Ho-Ro/Z80_dongle/Z80_dongle/TinyBasic2.h

#ifndef ROM_TB2_H
#define ROM_TB2_H

const unsigned char rom_tb2[] PROGMEM = {
    /* 0000 */ 0x31, 0x00, 0x09, 0x3e, 0xc9, 0xc3, 0x15, 0x01, 0xe3, 0xef, 0xbe, 0x23, 0x18, 0x61, 0x3e, 0x0d,
    /* 0010 */ 0xd3, 0x01, 0xfe, 0x0d, 0xc0, 0xc3, 0x01, 0x01, 0xcd, 0xda, 0x03, 0xe5, 0xc3, 0x96, 0x03, 0x57,
    /* 0020 */ 0x7c, 0xba, 0xc0, 0x7d, 0xbb, 0xc9, 0x00, 0x41, 0x1a, 0xfe, 0x20, 0xc0, 0x13, 0x18, 0xf9, 0x4e,
    /* 0030 */ 0xf1, 0xcd, 0x5e, 0x05, 0xc3, 0x71, 0x05, 0x47, 0xef, 0xd6, 0x40, 0xd8, 0x20, 0x1b, 0x13, 0xcd,
    /* 0040 */ 0x9e, 0x04, 0x29, 0xda, 0xdb, 0x00, 0x23, 0x23, 0xd5, 0xeb, 0xcd, 0xe0, 0x04, 0xe7, 0xda, 0x9f,
    /* 0050 */ 0x05, 0x21, 0x00, 0x21, 0xcd, 0x2b, 0x05, 0xd1, 0xc9, 0xfe, 0x21, 0x38, 0x02, 0xd6, 0x20, 0xfe,
    /* 0060 */ 0x1b, 0x3f, 0xd8, 0x13, 0x21, 0xfe, 0x07, 0x07, 0x85, 0x6f, 0x3e, 0x00, 0x8c, 0x67, 0xc9, 0x28,
    /* 0070 */ 0x07, 0xc5, 0x4e, 0x06, 0x00, 0x09, 0xc1, 0x1b, 0x13, 0x23, 0xe3, 0xc9, 0x21, 0x00, 0x00, 0x44,
    /* 0080 */ 0xcf, 0x27, 0x0b, 0x1a, 0x6f, 0x13, 0x1a, 0xfe, 0x27, 0x20, 0x6a, 0x13, 0x04, 0xc9, 0xfe, 0x24,
    /* 0090 */ 0x28, 0x22, 0xfe, 0x30, 0xd8, 0xfe, 0x3a, 0xd0, 0x3e, 0xf0, 0xa4, 0x20, 0x3e, 0x04, 0xc5, 0x44,
    /* 00a0 */ 0x4d, 0x29, 0x29, 0x09, 0x29, 0x1a, 0x13, 0xe6, 0x0f, 0x85, 0x6f, 0x3e, 0x00, 0x8c, 0x67, 0xc1,
    /* 00b0 */ 0x1a, 0xf2, 0x92, 0x00, 0x13, 0x1a, 0xfe, 0x30, 0xd8, 0xfe, 0x3a, 0x38, 0x0a, 0xfe, 0x41, 0xd8,
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
    /* 0260 */ 0x3a, 0x08, 0x7c, 0xb5, 0xca, 0x71, 0x05, 0xf9, 0xe1, 0x22, 0x3a, 0x08, 0xe1, 0x22, 0x38, 0x08,
    /* 0270 */ 0xd1, 0xcd, 0xd3, 0x06, 0xf7, 0xcd, 0xee, 0x06, 0xcd, 0x4f, 0x05, 0x2b, 0x22, 0x40, 0x08, 0x21,
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
};

#endif
