Ho-Ro/Z80_dongle/Z80_dongle/NascomBasic_GS.h

#ifndef ROM_GS_H
#define ROM_GS_H

// Credits
//
// * Original BASIC code was written by Microsoft.
// * Updates were made by Grant Searle.
// * Further updates from 8bitforce.

const uint8_t rom_gs[] PROGMEM = {
    /* 0000 */ 0xf3, 0xc3, 0x28, 0x00, 0x00, 0x00, 0x00, 0x00, 0xd3, 0x01, 0xc9, 0x00, 0x00, 0x00, 0x00, 0x00,
    /* 0010 */ 0xdf, 0x28, 0xfd, 0xdb, 0x01, 0xc9, 0x00, 0x00, 0xdb, 0x02, 0xe6, 0x01, 0xc9, 0x00, 0x00, 0x00,
    /* 0020 */ 0x7e, 0xb7, 0xc8, 0xcf, 0x23, 0x18, 0xf9, 0xc9, 0x21, 0x00, 0x3a, 0xf9, 0x3a, 0x00, 0x20, 0xfe,
    /* 0030 */ 0xc3, 0x20, 0x14, 0x21, 0x5d, 0x00, 0xcd, 0x20, 0x00, 0xd7, 0xe6, 0xdf, 0xfe, 0x43, 0x20, 0x0f,
    /* 0040 */ 0xcf, 0x3e, 0x0d, 0xcf, 0x3e, 0x0a, 0xcf, 0x3e, 0xc3, 0x32, 0x00, 0x20, 0xc3, 0x00, 0x01, 0xfe,
    /* 0050 */ 0x57, 0x20, 0xe6, 0xcf, 0x3e, 0x0d, 0xcf, 0x3e, 0x0a, 0xcf, 0xc3, 0x03, 0x01, 0x0d, 0x0a, 0x28,
    /* 0060 */ 0x43, 0x29, 0x6f, 0x6c, 0x64, 0x20, 0x6f, 0x72, 0x20, 0x28, 0x57, 0x29, 0x61, 0x72, 0x6d, 0x20,
    /* 0070 */ 0x73, 0x74, 0x61, 0x72, 0x74, 0x3f, 0x20, 0x00, 0x00, 0x00, 0x00, 0x00, 0x00, 0x00, 0x00, 0x00,
    /* 0080 */ 0x00, 0x00, 0x00, 0x00, 0x00, 0x00, 0x00, 0x00, 0x00, 0x00, 0x00, 0x00, 0x00, 0x00, 0x00, 0x00,
    /* 0090 */ 0x00, 0x00, 0x00, 0x00, 0x00, 0x00, 0x00, 0x00, 0x00, 0x00, 0x00, 0x00, 0x00, 0x00, 0x00, 0x00,
    /* 00a0 */ 0x00, 0x00, 0x00, 0x00, 0x00, 0x00, 0x00, 0x00, 0x00, 0x00, 0x00, 0x00, 0x00, 0x00, 0x00, 0x00,
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
    /* 1fe0 */ 0x00, 0x00, 0x00, 0x00, 0x00, 0x00, 0x00, 0x00, 0x00, 0x00, 0x00, 0x00, 0x00, 0x00, 0x00, 0x00,
    /* 1ff0 */ 0x00, 0x00, 0x00, 0x00, 0x00, 0x00, 0x00, 0x00, 0x00, 0x00, 0x00, 0x00, 0x00, 0x00, 0x00, 0x00
};

#endif
