Ho-Ro/Z80_dongle/Z80_dongle/NascomBasic_HP.h

#ifndef ROM_HP_H
#define ROM_HP_H

// Hein Pragt's modified version of Z80 Basic interpreter from Grant's site
// RAM top address is hardcoded at the command at $0185: 21 00 38 ; LD HL,$3800
// changed for my dongle: read RAM top from RAM (must be set before start of simulation
// $0185: 21 00 38 LD HL,$3800 -> 2A 00 20 LD HL, ($2000) (marked below)
// Check 6850 RDRF (receive data register full) bit only
// $0029: B7 C9 7E (OR A; RET; LD A,(HL)) -> E6 01 C9 (AND 1; RET)

const uint8_t rom_hp[] PROGMEM = {
    0xF3, 0xC3, 0x68, 0x01, 0x00, 0x00, 0x00, 0x00, 0xC3, 0x24, 0x00, 0x00, 0x00, 0x00, 0x00, 0x00, 0xC3, 0x1B, 0x00, 0x00, 0x00,
    0x00, 0x00, 0x00, 0xC3, 0x27, 0x00, 0xDB, 0x02, 0xFE, 0x00, 0x28, 0xFA, 0xDB, 0x01, 0xC9, 0xD3, 0x01, 0xC9, 0xDB, 0x01,
    // 0xB7, 0xC9, 0x7E, // OR A; RET; LD A; (HL)
    0xE6, 0x01, 0xC9, //    AND 1; RET
    0xB7, 0xC8, 0xCF, 0x23, 0x18, 0x39, 0xC9, 0x21, 0xED, 0x20, 0xF9, 0xFB, 0x21, 0x71, 0x00, 0xCD, 0x6B, 0x0B, 0x3A,
    0x00, 0x00, 0xFE, 0x59, 0x20, 0x16, 0x21, 0x8C, 0x00, 0xCD, 0x6B, 0x0B, 0xCD, 0x1B, 0x00, 0xE6, 0xDF, 0xFE, 0x43, 0x20, 0x0F,
    0xCF, 0x3E, 0x0D, 0xCF, 0x3E, 0x0A, 0xCF, 0x3E, 0x59, 0x32, 0x00, 0x00, 0xC3, 0x50, 0x01, 0xFE, 0x57, 0x20, 0xE4, 0xCF, 0x3E,
    0x0D, 0xCF, 0x3E, 0x0A, 0xCF, 0xC3, 0x53, 0x01, 0x0C, 0x5A, 0x38, 0x30, 0x20, 0x53, 0x42, 0x43, 0x20, 0x42, 0x79, 0x20, 0x47,
    0x72, 0x61, 0x6E, 0x74, 0x20, 0x53, 0x65, 0x61, 0x72, 0x6C, 0x65, 0x0D, 0x0A, 0x00, 0x0D, 0x0A, 0x43, 0x6F, 0x6C, 0x64, 0x20,
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
    0x00, 0x00, 0x00, 0x00, 0x00, 0x00, 0x00, 0x00, 0x00, 0x00, 0x00, 0x00, 0x00, 0x00, 0x00, 0x00, 0x00, 0x00, 0x00, 0x00, 0x00,
    0x00, 0x00, 0x00, 0x00, 0x00, 0x00, 0x00, 0x00, 0x00, 0x00, 0x00, 0x00, 0x00, 0x00, 0x00, 0x00, 0x00, 0x00, 0x00, 0x00, 0x00,
    0x00, 0x00,

};


#endif
