Ho-Ro/Z80_dongle/Z80_dongle/opcodes.h

PROGMEM const char opcode[][14] = {
    /*00*/ "NOP          ",
    /*01*/ "LD BC,NNNN   ",
    /*02*/ "LD (BC),A    ",
    /*03*/ "INC BC       ",
    /*04*/ "INC B        ",
    /*05*/ "DEC B        ",
    /*06*/ "LD B,NN      ",
    /*07*/ "RLCA         ",
    /*08*/ "EX AF,AF'    ",
    /*09*/ "ADD HL,BC    ",
    /*0A*/ "LD A,(BC)    ",
    /*0B*/ "DEC BC       ",
    /*0C*/ "INC C        ",
    /*0D*/ "DEC C        ",
    /*0E*/ "LD C,NN      ",
    /*0F*/ "RRCA         ",
    /*10*/ "DJNZ NN      ",
    /*11*/ "LD DE,NNNN   ",
    /*12*/ "LD (DE),A    ",
    /*13*/ "INC DE       ",
    /*14*/ "INC D        ",
    /*15*/ "DEC D        ",
    /*16*/ "LD D,NN      ",
    /*17*/ "RLA          ",
    /*18*/ "JR NN        ",
    /*19*/ "ADD HL,DE    ",
    /*1A*/ "LD A,(DE)    ",
    /*1B*/ "DEC DE       ",
    /*1C*/ "INC E        ",
    /*1D*/ "DEC E        ",
    /*1E*/ "LD E,NN      ",
    /*1F*/ "RRA          ",
    /*20*/ "JR NZ,NN     ",
    /*21*/ "LD HL,NNNN   ",
    /*22*/ "LD (NNNN),HL ",
    /*23*/ "INC HL       ",
    /*24*/ "INC H        ",
    /*25*/ "DEC H        ",
    /*26*/ "LD H,NN      ",
    /*27*/ "DAA          ",
    /*28*/ "JR Z,NN      ",
    /*29*/ "ADD HL,HL    ",
    /*2A*/ "LD HL,(NNNN) ",
    /*2B*/ "DEC HL       ",
    /*2C*/ "INC L        ",
    /*2D*/ "DEC L        ",
    /*2E*/ "LD L,NN      ",
    /*2F*/ "CPL          ",
    /*30*/ "JR NC,NN     ",
    /*31*/ "LD SP,NNNN   ",
    /*32*/ "LD (NNNN),A  ",
    /*33*/ "INC SP       ",
    /*34*/ "INC (HL)     ",
    /*35*/ "DEC (HL)     ",
    /*36*/ "LD (HL),NN   ",
    /*37*/ "SCF          ",
    /*38*/ "JR C,NN      ",
    /*39*/ "ADD HL,SP    ",
    /*3A*/ "LD A,(NNNN)  ",
    /*3B*/ "DEC SP       ",
    /*3C*/ "INC A        ",
    /*3D*/ "DEC A        ",
    /*3E*/ "LD A,NN      ",
    /*3F*/ "CCF          ",
    /*40*/ "LD B,B       ",
    /*41*/ "LD B,C       ",
    /*42*/ "LD B,D       ",
    /*43*/ "LD B,E       ",
    /*44*/ "LD B,H       ",
    /*45*/ "LD B,L       ",
    /*46*/ "LD B,(HL)    ",
    /*47*/ "LD B,A       ",
    /*48*/ "LD C,B       ",
    /*49*/ "LD C,C       ",
    /*4A*/ "LD C,D       ",
    /*4B*/ "LD C,E       ",
    /*4C*/ "LD C,H       ",
    /*4D*/ "LD C,L       ",
    /*4E*/ "LD C,(HL)    ",
    /*4F*/ "LD C,A       ",
    /*50*/ "LD D,B       ",
    /*51*/ "LD D,C       ",
    /*52*/ "LD D,D       ",
    /*53*/ "LD D,E       ",
    /*54*/ "LD D,H       ",
    /*55*/ "LD D,L       ",
    /*56*/ "LD D,(HL)    ",
    /*57*/ "LD D,A       ",
    /*58*/ "LD E,B       ",
    /*59*/ "LD E,C       ",
    /*5A*/ "LD E,D       ",
    /*5B*/ "LD E,E       ",
    /*5C*/ "LD E,H       ",
    /*5D*/ "LD E,L       ",
    /*5E*/ "LD E,(HL)    ",
    /*5F*/ "LD E,A       ",
    /*60*/ "LD H,B       ",
    /*61*/ "LD H,C       ",
    /*62*/ "LD H,D       ",
    /*63*/ "LD H,E       ",
    /*64*/ "LD H,H       ",
    /*65*/ "LD H,L       ",
    /*66*/ "LD H,(HL)    ",
    /*67*/ "LD H,A       ",
    /*68*/ "LD L,B       ",
    /*69*/ "LD L,C       ",
    /*6A*/ "LD L,D       ",
    /*6B*/ "LD L,E       ",
    /*6C*/ "LD L,H       ",
    /*6D*/ "LD L,L       ",
    /*6E*/ "LD L,(HL)    ",
    /*6F*/ "LD L,A       ",
    /*70*/ "LD (HL),B    ",
    /*71*/ "LD (HL),C    ",
    /*72*/ "LD (HL),D    ",
    /*73*/ "LD (HL),E    ",
    /*74*/ "LD (HL),H    ",
    /*75*/ "LD (HL),L    ",
    /*76*/ "HALT         ",
    /*77*/ "LD (HL),A    ",
    /*78*/ "LD A,B       ",
    /*79*/ "LD A,C       ",
    /*7A*/ "LD A,D       ",
    /*7B*/ "LD A,E       ",
    /*7C*/ "LD A,H       ",
    /*7D*/ "LD A,L       ",
    /*7E*/ "LD A,(HL)    ",
    /*7F*/ "LD A,A       ",
    /*80*/ "ADD A,B      ",
    /*81*/ "ADD A,C      ",
    /*82*/ "ADD A,D      ",
    /*83*/ "ADD A,E      ",
    /*84*/ "ADD A,H      ",
    /*85*/ "ADD A,L      ",
    /*86*/ "ADD A,(HL)   ",
    /*87*/ "ADD A,A      ",
    /*88*/ "ADC A,B      ",
    /*89*/ "ADC A,C      ",
    /*8A*/ "ADC A,D      ",
    /*8B*/ "ADC A,E      ",
    /*8C*/ "ADC A,H      ",
    /*8D*/ "ADC A,L      ",
    /*8E*/ "ADC A,(HL)   ",
    /*8F*/ "ADC A,A      ",
    /*90*/ "SUB B        ",
    /*91*/ "SUB C        ",
    /*92*/ "SUB D        ",
    /*93*/ "SUB E        ",
    /*94*/ "SUB H        ",
    /*95*/ "SUB L        ",
    /*96*/ "SUB (HL)     ",
    /*97*/ "SUB A        ",
    /*98*/ "SBC B        ",
    /*99*/ "SBC C        ",
    /*9A*/ "SBC D        ",
    /*9B*/ "SBC E        ",
    /*9C*/ "SBC H        ",
    /*9D*/ "SBC L        ",
    /*9E*/ "SBC (HL)     ",
    /*9F*/ "SBC A        ",
    /*A0*/ "AND B        ",
    /*A1*/ "AND C        ",
    /*A2*/ "AND D        ",
    /*A3*/ "AND E        ",
    /*A4*/ "AND H        ",
    /*A5*/ "AND L        ",
    /*A6*/ "AND (HL)     ",
    /*A7*/ "AND A        ",
    /*A8*/ "XOR B        ",
    /*A9*/ "XOR C        ",
    /*AA*/ "XOR D        ",
    /*AB*/ "XOR E        ",
    /*AC*/ "XOR H        ",
    /*AD*/ "XOR L        ",
    /*AE*/ "XOR (HL)     ",
    /*AF*/ "XOR A        ",
    /*B0*/ "OR B         ",
    /*B1*/ "OR C         ",
    /*B2*/ "OR D         ",
    /*B3*/ "OR E         ",
    /*B4*/ "OR H         ",
    /*B5*/ "OR L         ",
    /*B6*/ "OR (HL)      ",
    /*B7*/ "OR A         ",
    /*B8*/ "CP B         ",
    /*B9*/ "CP C         ",
    /*BA*/ "CP D         ",
    /*BB*/ "CP E         ",
    /*BC*/ "CP H         ",
    /*BD*/ "CP L         ",
    /*BE*/ "CP (HL)      ",
    /*BF*/ "CP A         ",
    /*C0*/ "RET NZ       ",
    /*C1*/ "POP BC       ",
    /*C2*/ "JP NZ,NNNN   ",
    /*C3*/ "JP NNNN      ",
    /*C4*/ "CALL NZ,NNNN ",
    /*C5*/ "PUSH BC      ",
    /*C6*/ "ADD A,NN     ",
    /*C7*/ "RST 0        ",
    /*C8*/ "RET Z        ",
    /*C9*/ "RET          ",
    /*CA*/ "JP Z,NNNN    ",
    /*CB*/ "PREFIX CB    ",
    /*CC*/ "CALL Z,NNNN  ",
    /*CD*/ "CALL NNNN    ",
    /*CE*/ "ADC A,NN     ",
    /*CF*/ "RST 8H       ",
    /*D0*/ "RET NC       ",
    /*D1*/ "POP DE       ",
    /*D2*/ "JP NC,NNNN   ",
    /*D3*/ "OUT (NN),A   ",
    /*D4*/ "CALL NC,NNNN ",
    /*D5*/ "PUSH DE      ",
    /*D6*/ "SUB NN       ",
    /*D7*/ "RST 10H      ",
    /*D8*/ "RET C        ",
    /*D9*/ "EXX          ",
    /*DA*/ "JP C,NNNN    ",
    /*DB*/ "IN A,(NN)    ",
    /*DC*/ "CALL C,NNNN  ",
    /*DD*/ "PREFIX DD    ",
    /*DE*/ "SBC A,NN     ",
    /*DF*/ "RST 18H      ",
    /*E0*/ "RET PO       ",
    /*E1*/ "POP HL       ",
    /*E2*/ "JP PO,NNNN   ",
    /*E3*/ "EX (SP),HL   ",
    /*E4*/ "CALL PO,NNNN ",
    /*E5*/ "PUSH HL      ",
    /*E6*/ "AND NN       ",
    /*E7*/ "RST 20H      ",
    /*E8*/ "RET PE       ",
    /*E9*/ "JP (HL)      ",
    /*EA*/ "JP PE,NNNN   ",
    /*EB*/ "EX DE,HL     ",
    /*EC*/ "CALL PE,NNNN ",
    /*ED*/ "PREFIX ED    ",
    /*EE*/ "XOR NN       ",
    /*EF*/ "RST 28H      ",
    /*F0*/ "RET P        ",
    /*F1*/ "POP AF       ",
    /*F2*/ "JP P,NNNN    ",
    /*F3*/ "DI           ",
    /*F4*/ "CALL P,NNNN  ",
    /*F5*/ "PUSH AF      ",
    /*F6*/ "OR NN        ",
    /*F7*/ "RST 30H      ",
    /*F8*/ "RET M        ",
    /*F9*/ "LD SP,HL     ",
    /*FA*/ "JP M,NNNN    ",
    /*FB*/ "EI           ",
    /*FC*/ "CALL M,NNNN  ",
    /*FD*/ "PREFIX FD    ",
    /*FE*/ "CP NN        ",
    /*FF*/ "RST 38H      "
};

PROGMEM const char opcodeCB[][14] = {
    /*00*/ "RLC B        ",
    /*01*/ "RLC C        ",
    /*02*/ "RLC D        ",
    /*03*/ "RLC E        ",
    /*04*/ "RLC H        ",
    /*05*/ "RLC L        ",
    /*06*/ "RLC (HL)     ",
    /*07*/ "RLC A        ",
    /*08*/ "RRC B        ",
    /*09*/ "RRC C        ",
    /*0A*/ "RRC D        ",
    /*0B*/ "RRC E        ",
    /*0C*/ "RRC H        ",
    /*0D*/ "RRC L        ",
    /*0E*/ "RRC (HL)     ",
    /*0F*/ "RRC A        ",
    /*10*/ "RL  B        ",
    /*11*/ "RL  C        ",
    /*12*/ "RL  D        ",
    /*13*/ "RL  E        ",
    /*14*/ "RL  H        ",
    /*15*/ "RL  L        ",
    /*16*/ "RL  (HL)     ",
    /*17*/ "RL  A        ",
    /*18*/ "RR  B        ",
    /*19*/ "RR  C        ",
    /*1A*/ "RR  D        ",
    /*1B*/ "RR  E        ",
    /*1C*/ "RR  H        ",
    /*1D*/ "RR  L        ",
    /*1E*/ "RR  (HL)     ",
    /*1F*/ "RR  A        ",
    /*20*/ "SLA B        ",
    /*21*/ "SLA C        ",
    /*22*/ "SLA D        ",
    /*23*/ "SLA E        ",
    /*24*/ "SLA H        ",
    /*25*/ "SLA L        ",
    /*26*/ "SLA (HL)     ",
    /*27*/ "SLA A        ",
    /*28*/ "SRA B        ",
    /*29*/ "SRA C        ",
    /*2A*/ "SRA D        ",
    /*2B*/ "SRA E        ",
    /*2C*/ "SRA H        ",
    /*2D*/ "SRA L        ",
    /*2E*/ "SRA (HL)     ",
    /*2F*/ "SRA A        ",
    /*30*/ "",
    /*31*/ "",
    /*32*/ "",
    /*33*/ "",
    /*34*/ "",
    /*35*/ "",
    /*36*/ "",
    /*37*/ "",
    /*38*/ "SRL B        ",
    /*39*/ "SRL C        ",
    /*3A*/ "SRL D        ",
    /*3B*/ "SRL E        ",
    /*3C*/ "SRL H        ",
    /*3D*/ "SRL L        ",
    /*3E*/ "SRL (HL)     ",
    /*3F*/ "SRL A        ",
    /*40*/ "BIT 0,B      ",
    /*41*/ "BIT 0,C      ",
    /*42*/ "BIT 0,D      ",
    /*43*/ "BIT 0,E      ",
    /*44*/ "BIT 0,H      ",
    /*45*/ "BIT 0,L      ",
    /*46*/ "BIT 0,(HL)   ",
    /*47*/ "BIT 0,A      ",
    /*48*/ "BIT 1,B      ",
    /*49*/ "BIT 1,C      ",
    /*4A*/ "BIT 1,D      ",
    /*4B*/ "BIT 1,E      ",
    /*4C*/ "BIT 1,H      ",
    /*4D*/ "BIT 1,L      ",
    /*4E*/ "BIT 1,(HL)   ",
    /*4F*/ "BIT 1,A      ",
    /*50*/ "BIT 2,B      ",
    /*51*/ "BIT 2,C      ",
    /*52*/ "BIT 2,D      ",
    /*53*/ "BIT 2,E      ",
    /*54*/ "BIT 2,H      ",
    /*55*/ "BIT 2,L      ",
    /*56*/ "BIT 2,(HL)   ",
    /*57*/ "BIT 2,A      ",
    /*58*/ "BIT 3,B      ",
    /*59*/ "BIT 3,C      ",
    /*5A*/ "BIT 3,D      ",
    /*5B*/ "BIT 3,E      ",
    /*5C*/ "BIT 3,H      ",
    /*5D*/ "BIT 3,L      ",
    /*5E*/ "BIT 3,(HL)   ",
    /*5F*/ "BIT 3,A      ",
    /*60*/ "BIT 4,B      ",
    /*61*/ "BIT 4,C      ",
    /*62*/ "BIT 4,D      ",
    /*63*/ "BIT 4,E      ",
    /*64*/ "BIT 4,H      ",
    /*65*/ "BIT 4,L      ",
    /*66*/ "BIT 4,(HL)   ",
    /*67*/ "BIT 4,A      ",
    /*68*/ "BIT 5,B      ",
    /*69*/ "BIT 5,C      ",
    /*6A*/ "BIT 5,D      ",
    /*6B*/ "BIT 5,E      ",
    /*6C*/ "BIT 5,H      ",
    /*6D*/ "BIT 5,L      ",
    /*6E*/ "BIT 5,(HL)   ",
    /*6F*/ "BIT 5,A      ",
    /*70*/ "BIT 6,B      ",
    /*71*/ "BIT 6,C      ",
    /*72*/ "BIT 6,D      ",
    /*73*/ "BIT 6,E      ",
    /*74*/ "BIT 6,H      ",
    /*75*/ "BIT 6,L      ",
    /*76*/ "BIT 6,(HL)   ",
    /*77*/ "BIT 6,A      ",
    /*78*/ "BIT 7,B      ",
    /*79*/ "BIT 7,C      ",
    /*7A*/ "BIT 7,D      ",
    /*7B*/ "BIT 7,E      ",
    /*7C*/ "BIT 7,H      ",
    /*7D*/ "BIT 7,L      ",
    /*7E*/ "BIT 7,(HL)   ",
    /*7F*/ "BIT 7,A      ",
    /*80*/ "RES 0,B      ",
    /*81*/ "RES 0,C      ",
    /*82*/ "RES 0,D      ",
    /*83*/ "RES 0,E      ",
    /*84*/ "RES 0,H      ",
    /*85*/ "RES 0,L      ",
    /*86*/ "RES 0,(HL)   ",
    /*87*/ "RES 0,A      ",
    /*88*/ "RES 1,B      ",
    /*89*/ "RES 1,C      ",
    /*8A*/ "RES 1,D      ",
    /*8B*/ "RES 1,E      ",
    /*8C*/ "RES 1,H      ",
    /*8D*/ "RES 1,L      ",
    /*8E*/ "RES 1,(HL)   ",
    /*8F*/ "RES 1,A      ",
    /*90*/ "RES 2,B      ",
    /*91*/ "RES 2,C      ",
    /*92*/ "RES 2,D      ",
    /*93*/ "RES 2,E      ",
    /*94*/ "RES 2,H      ",
    /*95*/ "RES 2,L      ",
    /*96*/ "RES 2,(HL)   ",
    /*97*/ "RES 2,A      ",
    /*98*/ "RES 3,B      ",
    /*99*/ "RES 3,C      ",
    /*9A*/ "RES 3,D      ",
    /*9B*/ "RES 3,E      ",
    /*9C*/ "RES 3,H      ",
    /*9D*/ "RES 3,L      ",
    /*9E*/ "RES 3,(HL)   ",
    /*9F*/ "RES 3,A      ",
    /*A0*/ "RES 4,B      ",
    /*A1*/ "RES 4,C      ",
    /*A2*/ "RES 4,D      ",
    /*A3*/ "RES 4,E      ",
    /*A4*/ "RES 4,H      ",
    /*A5*/ "RES 4,L      ",
    /*A6*/ "RES 4,(HL)   ",
    /*A7*/ "RES 4,A      ",
    /*A8*/ "RES 5,B      ",
    /*A9*/ "RES 5,C      ",
    /*AA*/ "RES 5,D      ",
    /*AB*/ "RES 5,E      ",
    /*AC*/ "RES 5,H      ",
    /*AD*/ "RES 5,L      ",
    /*AE*/ "RES 5,(HL)   ",
    /*AF*/ "RES 5,A      ",
    /*B0*/ "RES 6,B      ",
    /*B1*/ "RES 6,C      ",
    /*B2*/ "RES 6,D      ",
    /*B3*/ "RES 6,E      ",
    /*B4*/ "RES 6,H      ",
    /*B5*/ "RES 6,L      ",
    /*B6*/ "RES 6,(HL)   ",
    /*B7*/ "RES 6,A      ",
    /*B8*/ "RES 7,B      ",
    /*B9*/ "RES 7,C      ",
    /*BA*/ "RES 7,D      ",
    /*BB*/ "RES 7,E      ",
    /*BC*/ "RES 7,H      ",
    /*BD*/ "RES 7,L      ",
    /*BE*/ "RES 7,(HL)   ",
    /*BF*/ "RES 7,A      ",
    /*C0*/ "SET 0,B      ",
    /*C1*/ "SET 0,C      ",
    /*C2*/ "SET 0,D      ",
    /*C3*/ "SET 0,E      ",
    /*C4*/ "SET 0,H      ",
    /*C5*/ "SET 0,L      ",
    /*C6*/ "SET 0,(HL)   ",
    /*C7*/ "SET 0,A      ",
    /*C8*/ "SET 1,B      ",
    /*C9*/ "SET 1,C      ",
    /*CA*/ "SET 1,D      ",
    /*CB*/ "SET 1,E      ",
    /*CC*/ "SET 1,H      ",
    /*CD*/ "SET 1,L      ",
    /*CE*/ "SET 1,(HL)   ",
    /*CF*/ "SET 1,A      ",
    /*D0*/ "SET 2,B      ",
    /*D1*/ "SET 2,C      ",
    /*D2*/ "SET 2,D      ",
    /*D3*/ "SET 2,E      ",
    /*D4*/ "SET 2,H      ",
    /*D5*/ "SET 2,L      ",
    /*D6*/ "SET 2,(HL)   ",
    /*D7*/ "SET 2,A      ",
    /*D8*/ "SET 3,B      ",
    /*D9*/ "SET 3,C      ",
    /*DA*/ "SET 3,D      ",
    /*DB*/ "SET 3,E      ",
    /*DC*/ "SET 3,H      ",
    /*DD*/ "SET 3,L      ",
    /*DE*/ "SET 3,(HL)   ",
    /*DF*/ "SET 3,A      ",
    /*E0*/ "SET 4,B      ",
    /*E1*/ "SET 4,C      ",
    /*E2*/ "SET 4,D      ",
    /*E3*/ "SET 4,E      ",
    /*E4*/ "SET 4,H      ",
    /*E5*/ "SET 4,L      ",
    /*E6*/ "SET 4,(HL)   ",
    /*E7*/ "SET 4,A      ",
    /*E8*/ "SET 5,B      ",
    /*E9*/ "SET 5,C      ",
    /*EA*/ "SET 5,D      ",
    /*EB*/ "SET 5,E      ",
    /*EC*/ "SET 5,H      ",
    /*ED*/ "SET 5,L      ",
    /*EE*/ "SET 5,(HL)   ",
    /*EF*/ "SET 5,A      ",
    /*F0*/ "SET 6,B      ",
    /*F1*/ "SET 6,C      ",
    /*F2*/ "SET 6,D      ",
    /*F3*/ "SET 6,E      ",
    /*F4*/ "SET 6,H      ",
    /*F5*/ "SET 6,L      ",
    /*F6*/ "SET 6,(HL)   ",
    /*F7*/ "SET 6,A      ",
    /*F8*/ "SET 7,B      ",
    /*F9*/ "SET 7,C      ",
    /*FA*/ "SET 7,D      ",
    /*FB*/ "SET 7,E      ",
    /*FC*/ "SET 7,H      ",
    /*FD*/ "SET 7,L      ",
    /*FE*/ "SET 7,(HL)   ",
    /*FF*/ "SET 7,A      "
};

PROGMEM const char opcodeDD[][14] = {
    /*00*/ "",
    /*01*/ "",
    /*02*/ "",
    /*03*/ "",
    /*04*/ "",
    /*05*/ "",
    /*06*/ "",
    /*07*/ "",
    /*08*/ "",
    /*09*/ "ADD IX,BC    ",
    /*0A*/ "",
    /*0B*/ "",
    /*0C*/ "",
    /*0D*/ "",
    /*0E*/ "",
    /*0F*/ "",
    /*10*/ "",
    /*11*/ "",
    /*12*/ "",
    /*13*/ "",
    /*14*/ "",
    /*15*/ "",
    /*16*/ "",
    /*17*/ "",
    /*18*/ "",
    /*19*/ "ADD IX,DE    ",
    /*1A*/ "",
    /*1B*/ "",
    /*1C*/ "",
    /*1D*/ "",
    /*1E*/ "",
    /*1F*/ "",
    /*20*/ "",
    /*21*/ "LD IX,NNNN   ",
    /*22*/ "LD (NNNN),IX ",
    /*23*/ "INC IX       ",
    /*24*/ "INC IXH      ",
    /*25*/ "DEC IXH      ",
    /*26*/ "LD  IXH,NN   ",
    /*27*/ "",
    /*28*/ "",
    /*29*/ "ADD IX,IX    ",
    /*2A*/ "LD IX,(NNNN) ",
    /*2B*/ "DEC IX       ",
    /*2C*/ "INC IXL      ",
    /*2D*/ "DEC IXL      ",
    /*2E*/ "LD  IXL,NN   ",
    /*2F*/ "",
    /*30*/ "",
    /*31*/ "",
    /*32*/ "",
    /*33*/ "",
    /*34*/ "INC (IX+NN)  ",
    /*35*/ "DEC (IX+NN)  ",
    /*36*/ "LD (IX+NN),MM",
    /*37*/ "",
    /*38*/ "",
    /*39*/ "ADD IX,SP    ",
    /*3A*/ "",
    /*3B*/ "",
    /*3C*/ "",
    /*3D*/ "",
    /*3E*/ "",
    /*3F*/ "",
    /*40*/ "",
    /*41*/ "",
    /*42*/ "",
    /*43*/ "",
    /*44*/ "LD B,IXH     ",
    /*45*/ "LD B,IXL     ",
    /*46*/ "LD B,(IX+NN) ",
    /*47*/ "",
    /*48*/ "",
    /*49*/ "",
    /*4A*/ "",
    /*4B*/ "",
    /*4C*/ "LD C,IXH     ",
    /*4D*/ "LD C,IXL     ",
    /*4E*/ "LD C,(IX+NN) ",
    /*4F*/ "",
    /*50*/ "",
    /*51*/ "",
    /*52*/ "",
    /*53*/ "",
    /*54*/ "LD D,IXH     ",
    /*55*/ "LD D,IXL     ",
    /*56*/ "LD D,(IX+NN) ",
    /*57*/ "",
    /*58*/ "",
    /*59*/ "",
    /*5A*/ "",
    /*5B*/ "",
    /*5C*/ "LD E,IXH     ",
    /*5D*/ "LD E,IXL     ",
    /*5E*/ "LD E,(IX+NN) ",
    /*5F*/ "",
    /*60*/ "",
    /*61*/ "",
    /*62*/ "",
    /*63*/ "",
    /*64*/ "LD IXH,IXH   ",
    /*65*/ "LD IXH,IXL   ",
    /*66*/ "LD H,(IX+NN) ",
    /*67*/ "",
    /*68*/ "",
    /*69*/ "",
    /*6A*/ "",
    /*6B*/ "",
    /*6C*/ "LD IXL,IXH   ",
    /*6D*/ "LD IXL,IXL   ",
    /*6E*/ "LD L,(IX+NN) ",
    /*6F*/ "",
    /*70*/ "LD (IX+NN),B ",
    /*71*/ "LD (IX+NN),C ",
    /*72*/ "LD (IX+NN),D ",
    /*73*/ "LD (IX+NN),E ",
    /*74*/ "LD (IX+NN),H ",
    /*75*/ "LD (IX+NN),L ",
    /*76*/ "",
    /*77*/ "LD (IX+NN),A ",
    /*78*/ "",
    /*79*/ "",
    /*7A*/ "",
    /*7B*/ "",
    /*7C*/ "LD A,IXH     ",
    /*7D*/ "LD A,IXL     ",
    /*7E*/ "LD A,(IX+NN) ",
    /*7F*/ "",
    /*80*/ "",
    /*81*/ "",
    /*82*/ "",
    /*83*/ "",
    /*84*/ "ADD A,IXH    ",
    /*85*/ "ADD A,IXL    ",
    /*86*/ "ADD A,(IX+NN)",
    /*87*/ "",
    /*88*/ "",
    /*89*/ "",
    /*8A*/ "",
    /*8B*/ "",
    /*8C*/ "ADC A,IXH    ",
    /*8D*/ "ADC A,IXL    ",
    /*8E*/ "ADC A,(IX+NN)",
    /*8F*/ "",
    /*90*/ "",
    /*91*/ "",
    /*92*/ "",
    /*93*/ "",
    /*94*/ "SUB IXH      ",
    /*95*/ "SUB IXL      ",
    /*96*/ "SUB (IX+NN)  ",
    /*97*/ "",
    /*98*/ "",
    /*99*/ "",
    /*9A*/ "",
    /*9B*/ "",
    /*9C*/ "SBC A,IXH    ",
    /*9D*/ "SBC A,IXL    ",
    /*9E*/ "SBC A,(IX+NN)",
    /*9F*/ "",
    /*A0*/ "",
    /*A1*/ "",
    /*A2*/ "",
    /*A3*/ "",
    /*A4*/ "AND IXH      ",
    /*A5*/ "AND IXL      ",
    /*A6*/ "AND (IX+NN)  ",
    /*A7*/ "",
    /*A8*/ "",
    /*A9*/ "",
    /*AA*/ "",
    /*AB*/ "",
    /*AC*/ "XOR IXH      ",
    /*AD*/ "XOR IXL      ",
    /*AE*/ "XOR (IX+NN)  ",
    /*AF*/ "",
    /*B0*/ "",
    /*B1*/ "",
    /*B2*/ "",
    /*B3*/ "",
    /*B4*/ "OR IXH       ",
    /*B5*/ "OR IXL       ",
    /*B6*/ "OR (IX+NN)   ",
    /*B7*/ "",
    /*B8*/ "",
    /*B9*/ "",
    /*BA*/ "",
    /*BB*/ "",
    /*BC*/ "CP IXH       ",
    /*BD*/ "CP IXL       ",
    /*BE*/ "CP (IX+NN)   ",
    /*BF*/ "",
    /*C0*/ "",
    /*C1*/ "",
    /*C2*/ "",
    /*C3*/ "",
    /*C4*/ "",
    /*C5*/ "",
    /*C6*/ "",
    /*C7*/ "",
    /*C8*/ "",
    /*C9*/ "",
    /*CA*/ "",
    /*CB*/ "",
    /*CC*/ "",
    /*CD*/ "",
    /*CE*/ "",
    /*CF*/ "",
    /*D0*/ "",
    /*D1*/ "",
    /*D2*/ "",
    /*D3*/ "",
    /*D4*/ "",
    /*D5*/ "",
    /*D6*/ "",
    /*D7*/ "",
    /*D8*/ "",
    /*D9*/ "",
    /*DA*/ "",
    /*DB*/ "",
    /*DC*/ "",
    /*DD*/ "",
    /*DE*/ "",
    /*DF*/ "",
    /*E0*/ "",
    /*E1*/ "POP IX       ",
    /*E2*/ "",
    /*E3*/ "EX (SP),IX   ",
    /*E4*/ "",
    /*E5*/ "PUSH IX      ",
    /*E6*/ "",
    /*E7*/ "",
    /*E8*/ "",
    /*E9*/ "JP (IX)      ",
    /*EA*/ "",
    /*EB*/ "",
    /*EC*/ "",
    /*ED*/ "",
    /*EE*/ "",
    /*EF*/ "",
    /*F0*/ "",
    /*F1*/ "",
    /*F2*/ "",
    /*F3*/ "",
    /*F4*/ "",
    /*F5*/ "",
    /*F6*/ "",
    /*F7*/ "",
    /*F8*/ "",
    /*F9*/ "LD SP,IX     ",
    /*FA*/ "",
    /*FB*/ "",
    /*FC*/ "",
    /*FD*/ "",
    /*FE*/ "",
    /*FF*/ ""
};

PROGMEM const char opcodeDDCB[][14] = {
    /*00*/ "",
    /*01*/ "",
    /*02*/ "",
    /*03*/ "",
    /*04*/ "",
    /*05*/ "",
    /*06*/ "",
    /*07*/ "",
    /*08*/ "",
    /*09*/ "",
    /*0A*/ "",
    /*0B*/ "",
    /*0C*/ "",
    /*0D*/ "",
    /*0E*/ "",
    /*0F*/ "",
    /*10*/ "",
    /*11*/ "",
    /*12*/ "",
    /*13*/ "",
    /*14*/ "",
    /*15*/ "",
    /*16*/ "",
    /*17*/ "",
    /*18*/ "",
    /*19*/ "",
    /*1A*/ "",
    /*1B*/ "",
    /*1C*/ "",
    /*1D*/ "",
    /*1E*/ "",
    /*1F*/ "",
    /*20*/ "",
    /*21*/ "",
    /*22*/ "",
    /*23*/ "",
    /*24*/ "",
    /*25*/ "",
    /*26*/ "",
    /*27*/ "",
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
    /*56*/ "RLC (IX+NN)  ",
    /*56*/ "RRC (IX+NN)  ",
    /*56*/ "RL (IX+NN)   ",
    /*56*/ "RR (IX+NN)   ",
    /*56*/ "SLA (IX+NN)  ",
    /*56*/ "SRA (IX+NN)  ",
    /*56*/ "BIT 0,(IX+NN)",
    /*56*/ "BIT 1,(IX+NN)",
    /*56*/ "BIT 2,(IX+NN)",
    /*56*/ "BIT 3,(IX+NN)",
    /*56*/ "BIT 4,(IX+NN)",
    /*56*/ "BIT 5,(IX+NN)",
    /*56*/ "BIT 6,(IX+NN)",
    /*56*/ "BIT 7,(IX+NN)",
    /*56*/ "RES 0,(IX+NN)",
    /*56*/ "RES 1,(IX+NN)",
    /*56*/ "RES 2,(IX+NN)",
    /*56*/ "RES 3,(IX+NN)",
    /*56*/ "RES 4,(IX+NN)",
    /*56*/ "RES 5,(IX+NN)",
    /*56*/ "RES 6,(IX+NN)",
    /*56*/ "RES 7,(IX+NN)",
    /*56*/ "SET 0,(IX+NN)",
    /*56*/ "SET 1,(IX+NN)",
    /*56*/ "SET 2,(IX+NN)",
    /*56*/ "SET 3,(IX+NN)",
    /*56*/ "SET 4,(IX+NN)",
    /*56*/ "SET 5,(IX+NN)",
    /*56*/ "SET 6,(IX+NN)",
    /*56*/ "SET 7,(IX+NN)",
    /*57*/ "",
    /*58*/ "",
    /*59*/ "",
    /*5A*/ "",
    /*5B*/ "",
    /*5C*/ "",
    /*5D*/ "",
    /*5E*/ "",
    /*5F*/ "",
    /*60*/ "",
    /*61*/ "",
    /*62*/ "",
    /*63*/ "",
    /*64*/ "",
    /*65*/ "",
    /*66*/ "",
    /*67*/ "",
    /*68*/ "",
    /*69*/ "",
    /*6A*/ "",
    /*6B*/ "",
    /*6C*/ "",
    /*6D*/ "",
    /*6E*/ "",
    /*6F*/ "",
    /*70*/ "",
    /*71*/ "",
    /*72*/ "",
    /*73*/ "",
    /*74*/ "",
    /*75*/ "",
    /*76*/ "",
    /*77*/ "",
    /*78*/ "",
    /*79*/ "",
    /*7A*/ "",
    /*7B*/ "",
    /*7C*/ "",
    /*7D*/ "",
    /*7E*/ "",
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
    /*AA*/ "",
    /*AB*/ "",
    /*AC*/ "",
    /*AD*/ "",
    /*AE*/ "",
    /*AF*/ "",
    /*B0*/ "",
    /*B1*/ "",
    /*B2*/ "",
    /*B3*/ "",
    /*B4*/ "",
    /*B5*/ "",
    /*B6*/ "",
    /*B7*/ "",
    /*B8*/ "",
    /*B9*/ "",
    /*BA*/ "",
    /*BB*/ "",
    /*BC*/ "",
    /*BD*/ "",
    /*BE*/ "",
    /*BF*/ "",
    /*C0*/ "",
    /*C1*/ "",
    /*C2*/ "",
    /*C3*/ "",
    /*C4*/ "",
    /*C5*/ "",
    /*C6*/ "",
    /*C7*/ "",
    /*C8*/ "",
    /*C9*/ "",
    /*CA*/ "",
    /*CB*/ "",
    /*CC*/ "",
    /*CD*/ "",
    /*CE*/ "",
    /*CF*/ "",
    /*D0*/ "",
    /*D1*/ "",
    /*D2*/ "",
    /*D3*/ "",
    /*D4*/ "",
    /*D5*/ "",
    /*D6*/ "",
    /*D7*/ "",
    /*D8*/ "",
    /*D9*/ "",
    /*DA*/ "",
    /*DB*/ "",
    /*DC*/ "",
    /*DD*/ "",
    /*DE*/ "",
    /*DF*/ "",
    /*E0*/ "",
    /*E1*/ "",
    /*E2*/ "",
    /*E3*/ "",
    /*E4*/ "",
    /*E5*/ "",
    /*E6*/ "",
    /*E7*/ "",
    /*E8*/ "",
    /*E9*/ "",
    /*EA*/ "",
    /*EB*/ "",
    /*EC*/ "",
    /*ED*/ "",
    /*EE*/ "",
    /*EF*/ "",
    /*F0*/ "",
    /*F1*/ "",
    /*F2*/ "",
    /*F3*/ "",
    /*F4*/ "",
    /*F5*/ "",
    /*F6*/ "",
    /*F7*/ "",
    /*F8*/ "",
    /*F9*/ "",
    /*FA*/ "",
    /*FB*/ "",
    /*FC*/ "",
    /*FD*/ "",
    /*FE*/ "",
    /*FF*/ ""
};

PROGMEM const char opcodeED[][14] = {
    /*00*/ "",
    /*01*/ "",
    /*02*/ "",
    /*03*/ "",
    /*04*/ "",
    /*05*/ "",
    /*06*/ "",
    /*07*/ "",
    /*08*/ "",
    /*09*/ "",
    /*0A*/ "",
    /*0B*/ "",
    /*0C*/ "",
    /*0D*/ "",
    /*0E*/ "",
    /*0F*/ "",
    /*10*/ "",
    /*11*/ "",
    /*12*/ "",
    /*13*/ "",
    /*14*/ "",
    /*15*/ "",
    /*16*/ "",
    /*17*/ "",
    /*18*/ "",
    /*19*/ "",
    /*1A*/ "",
    /*1B*/ "",
    /*1C*/ "",
    /*1D*/ "",
    /*1E*/ "",
    /*1F*/ "",
    /*20*/ "",
    /*21*/ "",
    /*22*/ "",
    /*23*/ "",
    /*24*/ "",
    /*25*/ "",
    /*26*/ "",
    /*27*/ "",
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
    /*40*/ "IN B,(C)     ",
    /*41*/ "OUT (C),B    ",
    /*42*/ "SBC HL,BC    ",
    /*43*/ "LD (NNNN),BC ",
    /*44*/ "NEG          ",
    /*45*/ "RETN         ",
    /*46*/ "IM 0         ",
    /*47*/ "LD I,A       ",
    /*48*/ "IN C,(C)     ",
    /*49*/ "OUT (C),C    ",
    /*4A*/ "ADC HL,BC    ",
    /*4B*/ "LD BC,(NNNN) ",
    /*4C*/ "",
    /*4D*/ "RETI         ",
    /*4E*/ "",
    /*4F*/ "LD R,A       ",
    /*50*/ "IN D,(C)     ",
    /*51*/ "OUT (C),D    ",
    /*52*/ "SBC HL,DE    ",
    /*53*/ "LD (NNNN),DE ",
    /*54*/ "",
    /*55*/ "",
    /*56*/ "IM 1         ",
    /*57*/ "LD A,I       ",
    /*58*/ "IN E,(C)     ",
    /*59*/ "OUT (C),E    ",
    /*5A*/ "ADC HL,DE    ",
    /*5B*/ "LD DE,(NNNN) ",
    /*5C*/ "",
    /*5D*/ "",
    /*5E*/ "IM 2         ",
    /*5F*/ "LD A,R       ",
    /*60*/ "IN H,(C)     ",
    /*61*/ "OUT (C),H    ",
    /*62*/ "SBC HL,HL    ",
    /*63*/ "",
    /*64*/ "",
    /*65*/ "",
    /*66*/ "",
    /*67*/ "RRD          ",
    /*68*/ "IN L,(C)     ",
    /*69*/ "OUT (C),L    ",
    /*6A*/ "ADC HL,HL    ",
    /*6B*/ "",
    /*6C*/ "",
    /*6D*/ "",
    /*6E*/ "",
    /*6F*/ "RLD          ",
    /*70*/ "IN (C)       ",
    /*71*/ "OUT (C),0    ",
    /*72*/ "SBC HL,SP    ",
    /*73*/ "LD (NNNN),SP ",
    /*74*/ "",
    /*75*/ "",
    /*76*/ "",
    /*77*/ "",
    /*78*/ "IN A,(C)     ",
    /*79*/ "OUT (C),A    ",
    /*7A*/ "ADC HL,SP    ",
    /*7B*/ "LD SP,(NNNN) ",
    /*7C*/ "",
    /*7D*/ "",
    /*7E*/ "",
    /*7F*/ "",
    /*80*/ "",
    /*81*/ "",
    /*82*/ "",
    /*83*/ "",
    /*84*/ "",
    /*85*/ "",
    /*86*/ "",
    /*87*/ "",
    /*88*/ "",
    /*89*/ "",
    /*8A*/ "",
    /*8B*/ "",
    /*8C*/ "",
    /*8D*/ "",
    /*8E*/ "",
    /*8F*/ "",
    /*90*/ "",
    /*91*/ "",
    /*92*/ "",
    /*93*/ "",
    /*94*/ "",
    /*95*/ "",
    /*96*/ "",
    /*97*/ "",
    /*98*/ "",
    /*99*/ "",
    /*9A*/ "",
    /*9B*/ "",
    /*9C*/ "",
    /*9D*/ "",
    /*9E*/ "",
    /*9F*/ "",
    /*A0*/ "LDI          ",
    /*A1*/ "CPI          ",
    /*A2*/ "INI          ",
    /*A3*/ "OUTI         ",
    /*A4*/ "",
    /*A5*/ "",
    /*A6*/ "",
    /*A7*/ "",
    /*A8*/ "LDD          ",
    /*A9*/ "CPD          ",
    /*AA*/ "IND          ",
    /*AB*/ "OUTD         ",
    /*AC*/ "",
    /*AD*/ "",
    /*AE*/ "",
    /*AF*/ "",
    /*B0*/ "LDIR         ",
    /*B1*/ "CPIR         ",
    /*B2*/ "INIR         ",
    /*B3*/ "OTIR         ",
    /*B4*/ "",
    /*B5*/ "",
    /*B6*/ "",
    /*B7*/ "",
    /*B8*/ "LDDR         ",
    /*B9*/ "CPDR         ",
    /*BA*/ "INDR         ",
    /*BB*/ "OTDR         ",
    /*BC*/ "",
    /*BD*/ "",
    /*BE*/ "",
    /*BF*/ "",
    /*C0*/ "",
    /*C1*/ "",
    /*C2*/ "",
    /*C3*/ "",
    /*C4*/ "",
    /*C5*/ "",
    /*C6*/ "",
    /*C7*/ "",
    /*C8*/ "",
    /*C9*/ "",
    /*CA*/ "",
    /*CB*/ "",
    /*CC*/ "",
    /*CD*/ "",
    /*CE*/ "",
    /*CF*/ "",
    /*D0*/ "",
    /*D1*/ "",
    /*D2*/ "",
    /*D3*/ "",
    /*D4*/ "",
    /*D5*/ "",
    /*D6*/ "",
    /*D7*/ "",
    /*D8*/ "",
    /*D9*/ "",
    /*DA*/ "",
    /*DB*/ "",
    /*DC*/ "",
    /*DD*/ "",
    /*DE*/ "",
    /*DF*/ "",
    /*E0*/ "",
    /*E1*/ "",
    /*E2*/ "",
    /*E3*/ "",
    /*E4*/ "",
    /*E5*/ "",
    /*E6*/ "",
    /*E7*/ "",
    /*E8*/ "",
    /*E9*/ "",
    /*EA*/ "",
    /*EB*/ "",
    /*EC*/ "",
    /*ED*/ "",
    /*EE*/ "",
    /*EF*/ "",
    /*F0*/ "",
    /*F1*/ "",
    /*F2*/ "",
    /*F3*/ "",
    /*F4*/ "",
    /*F5*/ "",
    /*F6*/ "",
    /*F7*/ "",
    /*F8*/ "",
    /*F9*/ "",
    /*FA*/ "",
    /*FB*/ "",
    /*FC*/ "",
    /*FD*/ "",
    /*FE*/ "",
    /*FF*/ ""
};

PROGMEM const char opcodeFD[][14] = {
    /*00*/ "",
    /*01*/ "",
    /*02*/ "",
    /*03*/ "",
    /*04*/ "",
    /*05*/ "",
    /*06*/ "",
    /*07*/ "",
    /*08*/ "",
    /*09*/ "ADD IY,BC    ",
    /*0A*/ "",
    /*0B*/ "",
    /*0C*/ "",
    /*0D*/ "",
    /*0E*/ "",
    /*0F*/ "",
    /*10*/ "",
    /*11*/ "",
    /*12*/ "",
    /*13*/ "",
    /*14*/ "",
    /*15*/ "",
    /*16*/ "",
    /*17*/ "",
    /*18*/ "",
    /*19*/ "ADD IY,DE    ",
    /*1A*/ "",
    /*1B*/ "",
    /*1C*/ "",
    /*1D*/ "",
    /*1E*/ "",
    /*1F*/ "",
    /*20*/ "",
    /*21*/ "LD IY,NNNN   ",
    /*22*/ "LD (NNNN),IY ",
    /*23*/ "INC IY       ",
    /*24*/ "INC IYH      ",
    /*25*/ "DEC IYH      ",
    /*26*/ "LD  IYH,NN   ",
    /*27*/ "",
    /*28*/ "",
    /*29*/ "ADD IY,IY    ",
    /*2A*/ "LD IY,(NNNN) ",
    /*2B*/ "DEC IY       ",
    /*2C*/ "INC IYL      ",
    /*2D*/ "DEC IYL      ",
    /*2E*/ "LD  IYL,NN   ",
    /*2F*/ "",
    /*30*/ "",
    /*31*/ "",
    /*32*/ "",
    /*33*/ "",
    /*34*/ "INC (IY+NN)  ",
    /*35*/ "DEC (IY+NN)  ",
    /*36*/ "LD (IY+NN),MM",
    /*37*/ "",
    /*38*/ "",
    /*39*/ "ADD IY,SP    ",
    /*3A*/ "",
    /*3B*/ "",
    /*3C*/ "",
    /*3D*/ "",
    /*3E*/ "",
    /*3F*/ "",
    /*40*/ "",
    /*41*/ "",
    /*42*/ "",
    /*43*/ "",
    /*44*/ "LD B,IYH     ",
    /*45*/ "LD B,IYL     ",
    /*46*/ "LD B,(IY+NN) ",
    /*47*/ "",
    /*48*/ "",
    /*49*/ "",
    /*4A*/ "",
    /*4B*/ "",
    /*4C*/ "LD C,IYH     ",
    /*4D*/ "LD C,IYL     ",
    /*4E*/ "LD C,(IY+NN) ",
    /*4F*/ "",
    /*50*/ "",
    /*51*/ "",
    /*52*/ "",
    /*53*/ "",
    /*54*/ "LD D,IYH     ",
    /*55*/ "LD D,IYL     ",
    /*56*/ "LD D,(IY+NN) ",
    /*57*/ "",
    /*58*/ "",
    /*59*/ "",
    /*5A*/ "",
    /*5B*/ "",
    /*5C*/ "LD E,IYH     ",
    /*5D*/ "LD E,IYL     ",
    /*5E*/ "LD E,(IY+NN) ",
    /*5F*/ "",
    /*60*/ "",
    /*61*/ "",
    /*62*/ "",
    /*63*/ "",
    /*64*/ "LD IYH,IYH   ",
    /*65*/ "LD IYH,IYL   ",
    /*66*/ "LD H,(IY+NN) ",
    /*67*/ "",
    /*68*/ "",
    /*69*/ "",
    /*6A*/ "",
    /*6B*/ "",
    /*6C*/ "LD IYL,IYH   ",
    /*6D*/ "LD IYL,IYL   ",
    /*6E*/ "LD L,(IY+NN) ",
    /*6F*/ "",
    /*70*/ "LD (IY+NN),B ",
    /*71*/ "LD (IY+NN),C ",
    /*72*/ "LD (IY+NN),D ",
    /*73*/ "LD (IY+NN),E ",
    /*74*/ "LD (IY+NN),H ",
    /*75*/ "LD (IY+NN),L ",
    /*76*/ "",
    /*77*/ "LD (IY+NN),A ",
    /*78*/ "",
    /*79*/ "",
    /*7A*/ "",
    /*7B*/ "",
    /*7C*/ "LD A,IYH     ",
    /*7D*/ "LD A,IYL     ",
    /*7E*/ "LD A,(IY+NN) ",
    /*7F*/ "",
    /*80*/ "",
    /*81*/ "",
    /*82*/ "",
    /*83*/ "",
    /*84*/ "ADD A,IYH    ",
    /*85*/ "ADD A,IYL    ",
    /*86*/ "ADD A,(IY+NN)",
    /*87*/ "",
    /*88*/ "",
    /*89*/ "",
    /*8A*/ "",
    /*8B*/ "",
    /*8C*/ "ADC A,IYH    ",
    /*8D*/ "ADC A,IYL    ",
    /*8E*/ "ADC A,(IY+NN)",
    /*8F*/ "",
    /*90*/ "",
    /*91*/ "",
    /*92*/ "",
    /*93*/ "",
    /*94*/ "SUB IYH      ",
    /*95*/ "SUB IYL      ",
    /*96*/ "SUB (IY+NN)  ",
    /*97*/ "",
    /*98*/ "",
    /*99*/ "",
    /*9A*/ "",
    /*9B*/ "",
    /*9C*/ "SBC A,IYH    ",
    /*9D*/ "SBC A,IYL    ",
    /*9E*/ "SBC A,(IY+NN)",
    /*9F*/ "",
    /*A0*/ "",
    /*A1*/ "",
    /*A2*/ "",
    /*A3*/ "",
    /*A4*/ "AND IYH      ",
    /*A5*/ "AND IYL      ",
    /*A6*/ "AND (IY+NN)  ",
    /*A7*/ "",
    /*A8*/ "",
    /*A9*/ "",
    /*AA*/ "",
    /*AB*/ "",
    /*AC*/ "XOR IYH      ",
    /*AD*/ "XOR IYL      ",
    /*AE*/ "XOR (IY+NN)  ",
    /*AF*/ "",
    /*B0*/ "",
    /*B1*/ "",
    /*B2*/ "",
    /*B3*/ "",
    /*B4*/ "OR IYH       ",
    /*B5*/ "OR IYL       ",
    /*B6*/ "OR (IY+NN)   ",
    /*B7*/ "",
    /*B8*/ "",
    /*B9*/ "",
    /*BA*/ "",
    /*BB*/ "",
    /*BC*/ "CP IYH       ",
    /*BD*/ "CP IYL       ",
    /*BE*/ "CP (IY+NN)   ",
    /*BF*/ "",
    /*C0*/ "",
    /*C1*/ "",
    /*C2*/ "",
    /*C3*/ "",
    /*C4*/ "",
    /*C5*/ "",
    /*C6*/ "",
    /*C7*/ "",
    /*C8*/ "",
    /*C9*/ "",
    /*CA*/ "",
    /*CB*/ "",
    /*CC*/ "",
    /*CD*/ "",
    /*CE*/ "",
    /*CF*/ "",
    /*D0*/ "",
    /*D1*/ "",
    /*D2*/ "",
    /*D3*/ "",
    /*D4*/ "",
    /*D5*/ "",
    /*D6*/ "",
    /*D7*/ "",
    /*D8*/ "",
    /*D9*/ "",
    /*DA*/ "",
    /*DB*/ "",
    /*DC*/ "",
    /*DD*/ "",
    /*DE*/ "",
    /*DF*/ "",
    /*E0*/ "",
    /*E1*/ "POP IY       ",
    /*E2*/ "",
    /*E3*/ "EX (SP),IY   ",
    /*E4*/ "",
    /*E5*/ "PUSH IY      ",
    /*E6*/ "",
    /*E7*/ "",
    /*E8*/ "",
    /*E9*/ "JP (IY)      ",
    /*EA*/ "",
    /*EB*/ "",
    /*EC*/ "",
    /*ED*/ "",
    /*EE*/ "",
    /*EF*/ "",
    /*F0*/ "",
    /*F1*/ "",
    /*F2*/ "",
    /*F3*/ "",
    /*F4*/ "",
    /*F5*/ "",
    /*F6*/ "",
    /*F7*/ "",
    /*F8*/ "",
    /*F9*/ "LD SP,IY     ",
    /*FA*/ "",
    /*FB*/ "",
    /*FC*/ "",
    /*FD*/ "",
    /*FE*/ "",
    /*FF*/ ""
};

PROGMEM const char opcodeFDCB[][14] = {
    /*00*/ "",
    /*01*/ "",
    /*02*/ "",
    /*03*/ "",
    /*04*/ "",
    /*05*/ "",
    /*06*/ "",
    /*07*/ "",
    /*08*/ "",
    /*09*/ "",
    /*0A*/ "",
    /*0B*/ "",
    /*0C*/ "",
    /*0D*/ "",
    /*0E*/ "",
    /*0F*/ "",
    /*10*/ "",
    /*11*/ "",
    /*12*/ "",
    /*13*/ "",
    /*14*/ "",
    /*15*/ "",
    /*16*/ "",
    /*17*/ "",
    /*18*/ "",
    /*19*/ "",
    /*1A*/ "",
    /*1B*/ "",
    /*1C*/ "",
    /*1D*/ "",
    /*1E*/ "",
    /*1F*/ "",
    /*20*/ "",
    /*21*/ "",
    /*22*/ "",
    /*23*/ "",
    /*24*/ "",
    /*25*/ "",
    /*26*/ "",
    /*27*/ "",
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
    /*56*/ "RLC (IY+NN)  ",
    /*56*/ "RRC (IY+NN)  ",
    /*56*/ "RL (IY+NN)   ",
    /*56*/ "RR (IY+NN)   ",
    /*56*/ "SLA (IY+NN)  ",
    /*56*/ "SRA (IY+NN)  ",
    /*56*/ "BIT 0,(IY+NN)",
    /*56*/ "BIT 1,(IY+NN)",
    /*56*/ "BIT 2,(IY+NN)",
    /*56*/ "BIT 3,(IY+NN)",
    /*56*/ "BIT 4,(IY+NN)",
    /*56*/ "BIT 5,(IY+NN)",
    /*56*/ "BIT 6,(IY+NN)",
    /*56*/ "BIT 7,(IY+NN)",
    /*56*/ "RES 0,(IY+NN)",
    /*56*/ "RES 1,(IY+NN)",
    /*56*/ "RES 2,(IY+NN)",
    /*56*/ "RES 3,(IY+NN)",
    /*56*/ "RES 4,(IY+NN)",
    /*56*/ "RES 5,(IY+NN)",
    /*56*/ "RES 6,(IY+NN)",
    /*56*/ "RES 7,(IY+NN)",
    /*56*/ "SET 0,(IY+NN)",
    /*56*/ "SET 1,(IY+NN)",
    /*56*/ "SET 2,(IY+NN)",
    /*56*/ "SET 3,(IY+NN)",
    /*56*/ "SET 4,(IY+NN)",
    /*56*/ "SET 5,(IY+NN)",
    /*56*/ "SET 6,(IY+NN)",
    /*56*/ "SET 7,(IY+NN)",
    /*57*/ "",
    /*58*/ "",
    /*59*/ "",
    /*5A*/ "",
    /*5B*/ "",
    /*5C*/ "",
    /*5D*/ "",
    /*5E*/ "",
    /*5F*/ "",
    /*60*/ "",
    /*61*/ "",
    /*62*/ "",
    /*63*/ "",
    /*64*/ "",
    /*65*/ "",
    /*66*/ "",
    /*67*/ "",
    /*68*/ "",
    /*69*/ "",
    /*6A*/ "",
    /*6B*/ "",
    /*6C*/ "",
    /*6D*/ "",
    /*6E*/ "",
    /*6F*/ "",
    /*70*/ "",
    /*71*/ "",
    /*72*/ "",
    /*73*/ "",
    /*74*/ "",
    /*75*/ "",
    /*76*/ "",
    /*77*/ "",
    /*78*/ "",
    /*79*/ "",
    /*7A*/ "",
    /*7B*/ "",
    /*7C*/ "",
    /*7D*/ "",
    /*7E*/ "",
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
    /*AA*/ "",
    /*AB*/ "",
    /*AC*/ "",
    /*AD*/ "",
    /*AE*/ "",
    /*AF*/ "",
    /*B0*/ "",
    /*B1*/ "",
    /*B2*/ "",
    /*B3*/ "",
    /*B4*/ "",
    /*B5*/ "",
    /*B6*/ "",
    /*B7*/ "",
    /*B8*/ "",
    /*B9*/ "",
    /*BA*/ "",
    /*BB*/ "",
    /*BC*/ "",
    /*BD*/ "",
    /*BE*/ "",
    /*BF*/ "",
    /*C0*/ "",
    /*C1*/ "",
    /*C2*/ "",
    /*C3*/ "",
    /*C4*/ "",
    /*C5*/ "",
    /*C6*/ "",
    /*C7*/ "",
    /*C8*/ "",
    /*C9*/ "",
    /*CA*/ "",
    /*CB*/ "",
    /*CC*/ "",
    /*CD*/ "",
    /*CE*/ "",
    /*CF*/ "",
    /*D0*/ "",
    /*D1*/ "",
    /*D2*/ "",
    /*D3*/ "",
    /*D4*/ "",
    /*D5*/ "",
    /*D6*/ "",
    /*D7*/ "",
    /*D8*/ "",
    /*D9*/ "",
    /*DA*/ "",
    /*DB*/ "",
    /*DC*/ "",
    /*DD*/ "",
    /*DE*/ "",
    /*DF*/ "",
    /*E0*/ "",
    /*E1*/ "",
    /*E2*/ "",
    /*E3*/ "",
    /*E4*/ "",
    /*E5*/ "",
    /*E6*/ "",
    /*E7*/ "",
    /*E8*/ "",
    /*E9*/ "",
    /*EA*/ "",
    /*EB*/ "",
    /*EC*/ "",
    /*ED*/ "",
    /*EE*/ "",
    /*EF*/ "",
    /*F0*/ "",
    /*F1*/ "",
    /*F2*/ "",
    /*F3*/ "",
    /*F4*/ "",
    /*F5*/ "",
    /*F6*/ "",
    /*F7*/ "",
    /*F8*/ "",
    /*F9*/ "",
    /*FA*/ "",
    /*FB*/ "",
    /*FC*/ "",
    /*FD*/ "",
    /*FE*/ "",
    /*FF*/ ""
};
