Ho-Ro/Z80_dongle/Z80_dongle/NascomBasic.h

#ifndef NASCOMBASIC_H
#define NASCOMBASIC_H

// Credits
//
// * Original BASIC code was written by Microsoft.
// * Updates were made by Grant Searle.
// * Further updates from 8bitforce.

PROGMEM const byte rom[] = {

    // static const unsigned char intmini_data[] =
    0xf3, 0xc3, 0xa2, 0x00, 0x00, 0x00, 0x00, 0x00,

    // static const unsigned char intmini_2_data[] =
    0xc3, 0x91, 0x00, 0x00, 0x00, 0x00, 0x00, 0x00,

    // static const unsigned char intmini_3_data[] =
    0xc3, 0x6a, 0x00, 0x00, 0x00, 0x00, 0x00, 0x00,

    // static const unsigned char intmini_4_data[] =
    0xc3, 0x94, 0x00, 0x00, 0x00, 0x00, 0x00, 0x00, 0x00, 0x00, 0x00, 0x00, 0x00, 0x00, 0x00, 0x00, 0x00, 0x00, 0x00, 0x00, 0x00,
    0x00, 0x00, 0x00, 0x00, 0x00, 0x00, 0x00, 0x00, 0x00, 0x00, 0x00,

    // static const unsigned char intmini_5_data[] =
    0x18, 0x00, 0xf5, 0xe5, 0xdb, 0x00, 0xf5, 0x3a, 0x43, 0x20, 0xfe, 0x3f, 0x20, 0x03, 0xf1, 0x18, 0x1c, 0x2a, 0x3f, 0x20, 0x23,
    0x7d, 0xfe, 0x3f, 0x20, 0x03, 0x21, 0x00, 0x20, 0x22, 0x3f, 0x20, 0xf1, 0x77, 0x3a, 0x43, 0x20, 0x3c, 0x32, 0x43, 0x20, 0xfe,
    0x30, 0x38, 0x00, 0xe1, 0xf1, 0xfb, 0xed, 0x4d, 0x3a, 0x43, 0x20, 0xfe, 0x00, 0x28, 0xf9, 0xe5, 0x2a, 0x41, 0x20, 0x23, 0x7d,
    0xfe, 0x3f, 0x20, 0x03, 0x21, 0x00, 0x20, 0xf3, 0x22, 0x41, 0x20, 0x3a, 0x43, 0x20, 0x3d, 0x32, 0x43, 0x20, 0xfe, 0x05, 0x30,
    0x00, 0x7e, 0xfb, 0xe1, 0xc9, 0xd3, 0x00, 0xc9, 0x3a, 0x43, 0x20, 0xfe, 0x00, 0xc9, 0x7e, 0xb7, 0xc8, 0xcf, 0x23, 0x18, 0xf9,
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
    0xc9, 0x01, 0xff, 0x1c, 0x00, 0x00, 0x14, 0x00, 0x14, 0x00, 0x00, 0x00, 0x00, 0x00, 0xc3, 0x42, 0x07, 0xc3, 0x00, 0x00, 0xc3,
    0x00, 0x00, 0xc3, 0x00, 0x00, 0xa2, 0x21, 0xfe, 0xff, 0x3f, 0x21, 0x20, 0x45, 0x72, 0x72, 0x6f, 0x72, 0x00, 0x20, 0x69, 0x6e,
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

};

#endif
