Ho-Ro/Z80_dongle/Z80_dongle/basic1K.h

#ifndef ROM_B1K_H
#define ROM_B1K_H

const unsigned char rom_b1k[] PROGMEM = {
    /* 0000 */ 0x21, 0x40, 0x04, 0x22, 0x00, 0x04, 0x18, 0x73, 0xd3, 0x01, 0xaf, 0xc9, 0x00, 0x00, 0x00, 0x00,
    /* 0010 */ 0x0a, 0x00, 0x03, 0xe3, 0xbe, 0x23, 0xe3, 0xc9, 0xe3, 0xbe, 0x23, 0x20, 0xf8, 0x6e, 0x18, 0xf5,
    /* 0020 */ 0x00, 0x00, 0x00, 0x00, 0x00, 0x00, 0x00, 0x00, 0x7d, 0xab, 0xc0, 0x7c, 0xaa, 0xc0, 0x37, 0xc9,
    /* 0030 */ 0x1b, 0x7b, 0x2f, 0x5f, 0x7a, 0x2f, 0x57, 0xc9, 0xd7, 0xb8, 0x28, 0x5e, 0xdf, 0xe5, 0x6c, 0xfe,
    /* 0040 */ 0xc0, 0x30, 0x68, 0xfe, 0xb4, 0x30, 0x54, 0xfe, 0x20, 0x38, 0x06, 0x20, 0x5e, 0x60, 0x69, 0x03,
    /* 0050 */ 0x03, 0xdc, 0xf2, 0x02, 0x5e, 0x23, 0x56, 0xe1, 0x7c, 0x3d, 0x20, 0x0a, 0x7d, 0xfe, 0xe6, 0x30,
    /* 0060 */ 0xb5, 0x0a, 0x3d, 0xbd, 0x38, 0xb0, 0xe5, 0x0a, 0xfe, 0xcc, 0xd8, 0x03, 0x21, 0x3c, 0x11, 0x00,
    /* 0070 */ 0x00, 0x21, 0x57, 0x00, 0xe5, 0xd5, 0x6f, 0x24, 0xe5, 0x18, 0xbd, 0x18, 0x3e, 0xe5, 0xd7, 0xab,
    /* 0080 */ 0xc4, 0xab, 0x00, 0xff, 0xf7, 0xd5, 0x11, 0x01, 0x00, 0x0a, 0xdf, 0xac, 0x8d, 0x21, 0x03, 0xff,
    /* 0090 */ 0xe1, 0xe1, 0xc5, 0x3b, 0x3b, 0xd5, 0xe5, 0xc3, 0x8b, 0x02, 0x0b, 0x21, 0x57, 0x00, 0xe5, 0x6f,
    /* 00a0 */ 0x24, 0xe5, 0xd7, 0xb8, 0xc4, 0xab, 0x00, 0xff, 0xd7, 0xad, 0xc8, 0xcd, 0x46, 0x02, 0x3e, 0x45,
    /* 00b0 */ 0xcf, 0xd1, 0xcd, 0x62, 0x03, 0x00, 0x00, 0x00, 0x00, 0x00, 0x00, 0x31, 0xf8, 0x0f, 0xcd, 0x46,
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
    /* 0260 */ 0x0f, 0xc5, 0xe5, 0xcd, 0x32, 0x01, 0xc1, 0xff, 0xc1, 0xe1, 0x73, 0x23, 0x72, 0xc9, 0x21, 0x7d,
    /* 0270 */ 0x00, 0xe5, 0xcd, 0xed, 0x02, 0xe5, 0xd7, 0xda, 0xc4, 0xab, 0x00, 0xff, 0x18, 0xeb, 0xff, 0x7a,
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
};

#endif
