Ho-Ro/Z80_dongle/(commit log)

2024-09-18 more function; safe ram mirror handling; wiring documentation; README upd.
    e0 - set echo off (default)
    e1 - set echo on
    s - show simulation variables
    s N VALUE - set simulation variable number N to a VALUE
    sc - clear simulation variables to their default values
    r - restart the simulation
    :INTEL-HEX - reload RAM buffer with a given data stream
    m START END - dump the RAM buffer from START to END
    mx START END - dump the RAM buffer as ihex from START to END
    mc - clear the RAM buffer
    ms ADR B B B .. - set RAM buffer at ADR with data byte(s) B
    vN - set verboseMode to N (default = 0)
    Sign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
    [wiring.ods]
2024-09-19 more functions; update README; CPU detection example program
    sR - reset simulation variables to their default values
    :INTEL-HEX - reload RAM buffer with ihex data stream
    .INTEL-HEX - reload IO buffer with a modified ihex data stream
    mR - reset the RAM buffer to 00
    i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
    [Wiring_Z80_dongle.ods, wiring.ods]
2024-09-26 single step; dynamic mem size for HP's basic; Makefile for arduino-cli
2024-09-27 Basic RD/WR triggers interrupts -> Mega; Grant's intmini w/o INT38
2024-09-28 reset condition and timing; control handler allows continue of trace
    [Z80_dongle.ino]
2024-09-29 fix basic analyse continue cmd
    [Z80_dongle.ino]
2024-10-10 add Wang's tiny BASIC, hex file can be run with dongle command 'X'
    8080 code, syntax ready for uz80as assembler (--target=i8080)
    additional functions PEEK, DEEK; print numbers with variable base 2..16
2024-10-11 add hex format for numbers: $xxxx; remove ^O output switch
2024-10-15 fix multiplication of negative number with zero;
    [TinyBasic2.h, Z80_dongle.ino, tinybasic2.asm, tinybasic2_8080.asm]
2024-10-15 fix print number format, ignore base < %2
    [TinyBasic2.h, tinybasic2.asm]
2024-10-16 JP -> JR; PRINT %n -> unsigned unless n=0 (default); POKE ADDR,VAL,VAL,..
2024-10-19 convert uz80as format to the more authentic zmac format
    zmac originally dated to 4/78 fits better for the historic Tiny BASIC SW
    also uz80as ignores rel jump addr overflow :(
    so I do not trust this assembler anymore
2024-10-21 rearrange the RAM content: RAM:var,stack; TXT:text; TOP:usrspc,buffer
    PRINT %16,RAM,TXT,TOP -> $800 $900 $2100
2024-10-29 add basic1K "ROM"; add upper case mode for runWithInterrupt()
2024-10-30 dongle: LED 13 on when Z80 is running
2024-11-06 check GOSUB stack; print var as ASCII with \v; smaller code; cleanup
2024-11-29 clarification, thank you funkenzupfer
    https://forum.classic-computing.de/forum/index.php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
